takaki-maeda-99/PowerControlBoard/kicad/PowerControlBoard/PowerControlBoard.kicad_pcb

## KiCad design kicad/PowerControlBoard/PowerControlBoard.kicad_pcb (2025-08-18)

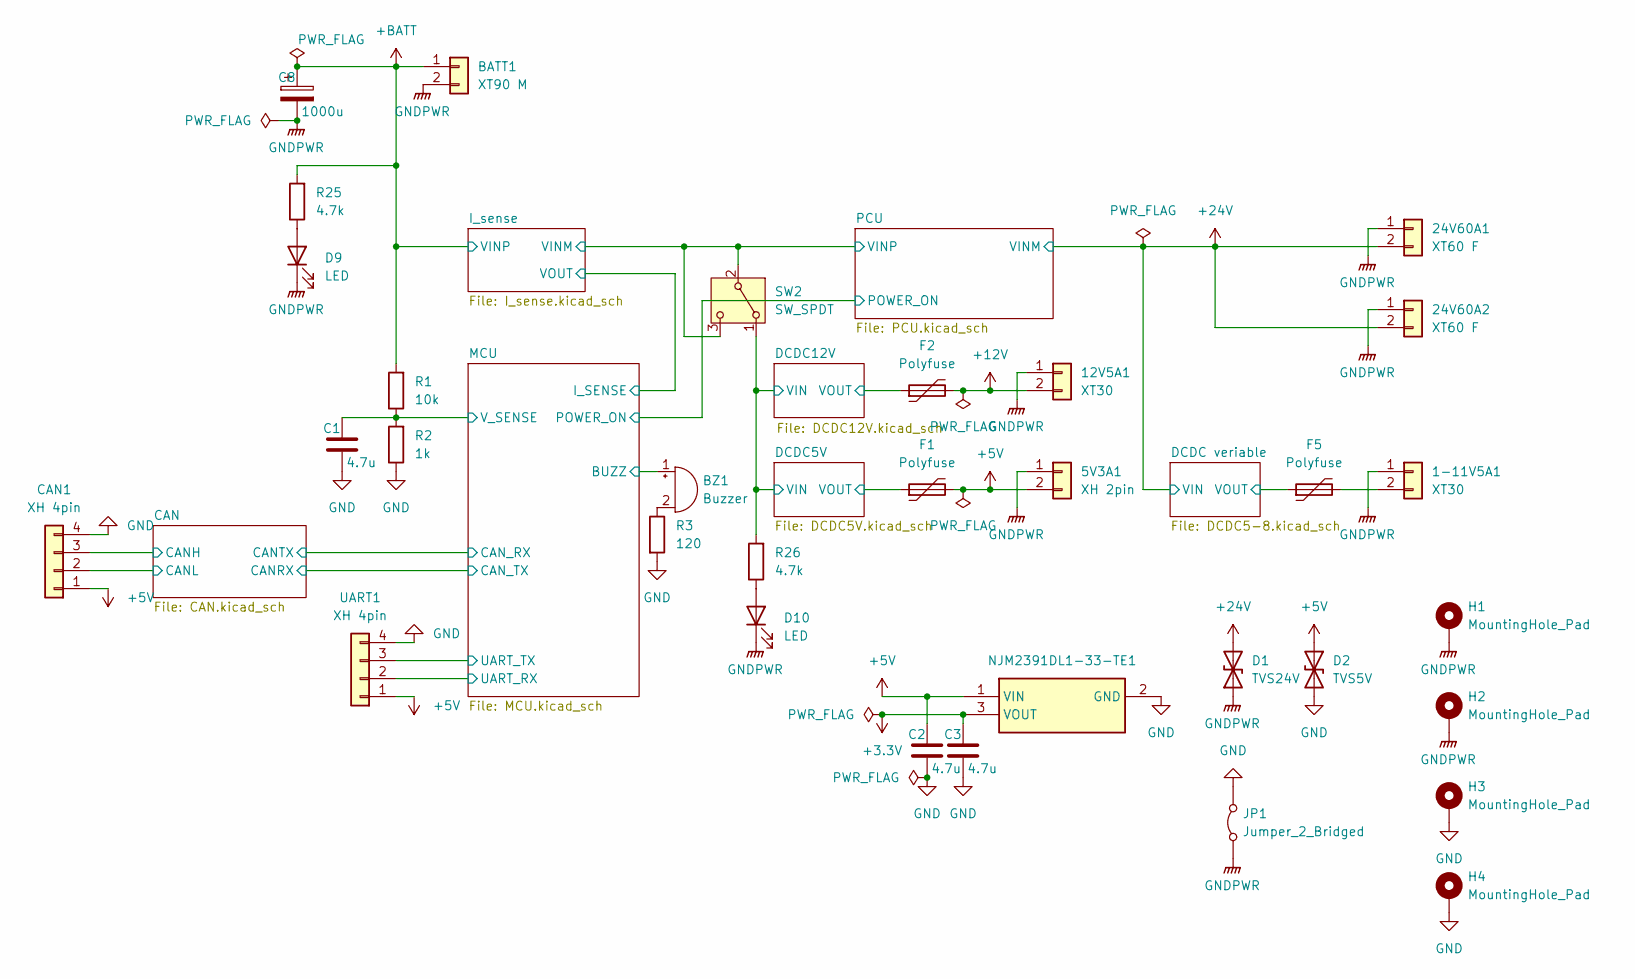
[picture p1: schematic PowerControlBoard.kicad_sch]

Parts:
1-11V5A1, 12V5A1: XT30; XT30UPBF
5V3A1: XH 2pin; JST_XH_S2B-XH-A_1x02_P2.50mm_Horizontal
24V60A1, 24V60A2: XT60 F; AMASS_XT60-F_1x02_P7.20mm_Vertical
BATT1: XT90 M; XT90PBF
BZ1: Buzzer; Buzzer_CUI_CPT-9019S-SMT
C1, C2, C3: 4.7u; C_0603_1608Metric
C8: 1000u; CP_Radial_D12.5mm_P5.00mm
CAN1: XH 4pin; JST_XH_S4B-XH-A_1x04_P2.50mm_Horizontal
D1: TVS24V; TO-277A
D2: TVS5V; D_SMB
D9, D10: LED; LED_0603_1608Metric
F1, F2, F5: Polyfuse; Fuse_Bourns_MF-RG500
H1, H2, H3, H4: MountingHole_Pad; MountingHole_3.2mm_M3_Pad
IC1: NJM2391DL1-33-TE1; NJM2391DL133TE1; Mouser Part Number 513-NJM2391DL133-TE1
JP1: Jumper_2_Bridged; SolderJumper-2_P1.3mm_Bridged2Bar_RoundedPad1.0x1.5mm
R1: 10k; R_0603_1608Metric
R2: 1k; R_0603_1608Metric
R3: 120; R_0603_1608Metric
R25, R26: 4.7k; C_0603_1608Metric
SW2: SW_SPDT; FanPinHeader_1x03_P2.54mm_Vertical
UART1: XH 4pin; JST_XH_S4B-XH-A_1x04_P2.50mm_Horizontal

Connections:
+3.3V: C3.1, IC1.3 (VOUT); also elsewhere on the board
+5V: 5V3A1.2, C2.1, CAN1.1, D2.1 (A1), F1.2, IC1.1 (VIN), UART1.1; also elsewhere on the board
+12V: 12V5A1.2, F2.2
+24V: 24V60A1.2, 24V60A2.2, D1.2 (A2); also elsewhere on the board
+BATT: BATT1.1, C8.1, R1.2, R25.2; also elsewhere on the board
/CAN/CANH: CAN1.3; also elsewhere on the board
/CAN/CANL: CAN1.2; also elsewhere on the board
/DCDC5V/VOUT: F1.1; also elsewhere on the board
/DCDC12V/VIN: R26.2, SW2.1 (A); also elsewhere on the board
/DCDC12V/VOUT: F2.1; also elsewhere on the board
/DCDC veriable/VOUT: F5.1; also elsewhere on the board
/I_sense/VINM: SW2.2 (B), SW2.3 (C); also elsewhere on the board
/MCU/BUZZ: BZ1.1 (+); also elsewhere on the board
/MCU/UART_RX: UART1.2; also elsewhere on the board
/MCU/UART_TX: UART1.3; also elsewhere on the board
/MCU/V_SENSE: C1.1, R1.1, R2.2; also elsewhere on the board
GND: C1.2, C2.2, C3.2, CAN1.4, D2.2 (A2), H3.1, H4.1, IC1.2 (GND), JP1.2 (B), R2.1, R3.2, UART1.4; also elsewhere on the board
GNDPWR: 1-11V5A1.1, 5V3A1.1, 12V5A1.1, 24V60A1.1, 24V60A2.1, BATT1.2, C8.2, D1.1 (A1), D9.1 (K), D10.1 (K), H1.1, H2.1, JP1.1 (A); also elsewhere on the board
unnamed: 1-11V5A1.2, F5.2
unnamed: BZ1.2 (-), R3.1
unnamed: D9.2 (A), R25.1
unnamed: D10.2 (A), R26.1

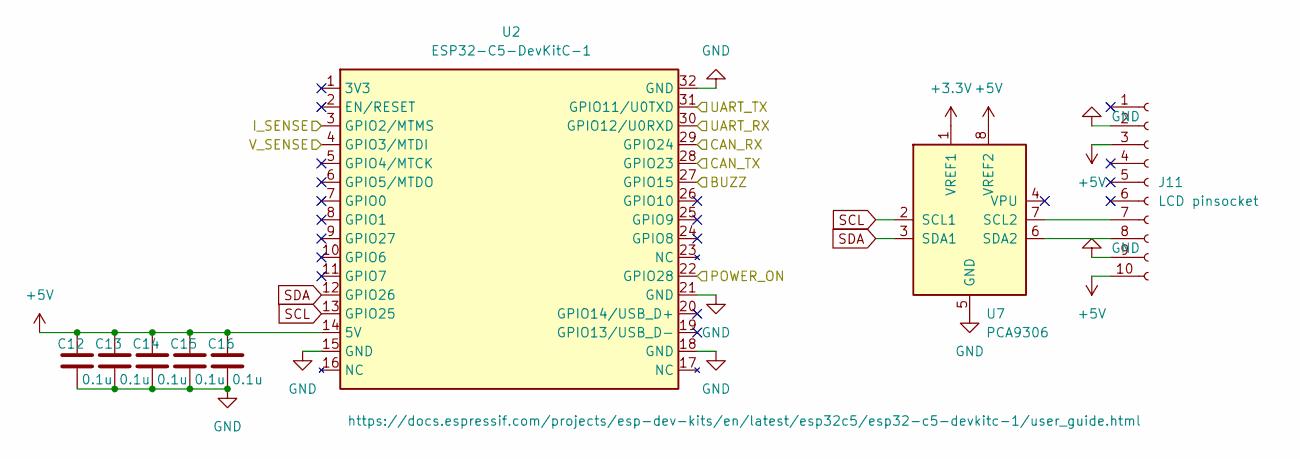
[picture p2: schematic MCU.kicad_sch]

Parts:
C12, C13, C14, C15, C16: 0.1u; C_0603_1608Metric
J11: LCD pinsocket; PinSocket_1x10_P2.54mm_Vertical
U2: ESP32-C5-DevKitC-1
U7: PCA9306; DIP-8_W10.16mm

Connections:
+3.3V: U7.1 (VREF1); also elsewhere on the board
+5V: C12.1, C13.1, C14.1, C15.1, C16.1, J11.3, J11.10, U2.14 (5V), U7.8 (VREF2); also elsewhere on the board
/CAN/CANRX: U2.28 (GPIO23); also elsewhere on the board
/CAN/CANTX: U2.29 (GPIO24); also elsewhere on the board
/I_sense/VOUT: U2.3 (GPIO2/MTMS); also elsewhere on the board
/MCU/BUZZ: U2.27 (GPIO15); also elsewhere on the board
/MCU/POWER_ON: U2.22 (GPIO28); also elsewhere on the board
/MCU/UART_RX: U2.30 (GPIO12/U0RXD); also elsewhere on the board
/MCU/UART_TX: U2.31 (GPIO11/U0TXD); also elsewhere on the board
/MCU/V_SENSE: U2.4 (GPIO3/MTDI); also elsewhere on the board
GND: C12.2, C13.2, C14.2, C15.2, C16.2, J11.2, J11.9, U2.15 (GND), U2.18 (GND), U2.21 (GND), U2.32 (GND), U7.5 (GND); also elsewhere on the board
unnamed: J11.7, U7.7 (SCL2)
unnamed: J11.8, U7.6 (SDA2)
SCL: U2.13 (GPIO25), U7.2 (SCL1)
SDA: U2.12 (GPIO26), U7.3 (SDA1)

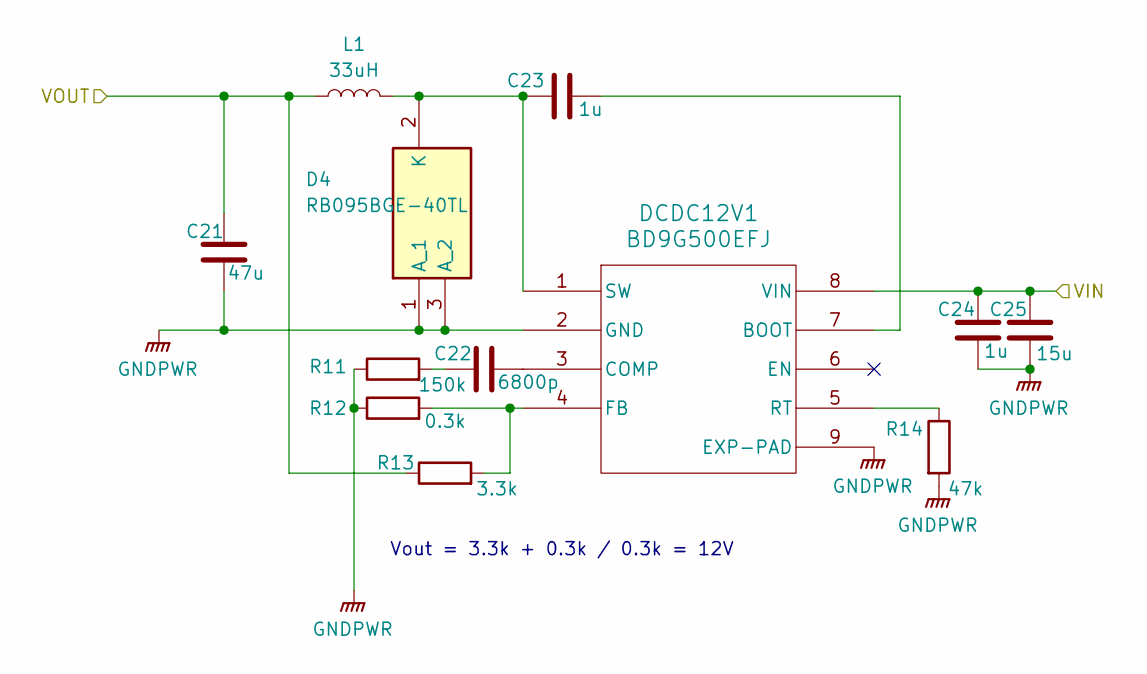
[picture p3: schematic DCDC12V.kicad_sch]

Parts:
C21: 47u; C_1206_3216Metric
C22: 6800p; C_0603_1608Metric
C23, C24: 1u; C_0603_1608Metric
C25: 15u; C_2220_5750Metric
D4: RB095BGE-40TL; RD3P175SNFRATL; Manufacturer_Part_Number RB095BGE-40TL; Mouser Part Number 755-RB095BGE-40TL
DCDC12V1: BD9G500EFJ; HTSOP-J8
L1: 33uH; IND_CSEB0660H-330M
R11: 150k; R_0603_1608Metric
R12: 0.3k; R_0603_1608Metric
R13: 3.3k; R_0603_1608Metric
R14: 47k; R_0603_1608Metric

Connections:
/DCDC12V/VIN: C24.1, C25.1, DCDC12V1.8 (VIN); also elsewhere on the board
/DCDC12V/VOUT: C21.2, L1.1, R13.1; also elsewhere on the board
GNDPWR: C21.1, C24.2, C25.2, D4.1 (A_1), D4.3 (A_2), DCDC12V1.2 (GND), DCDC12V1.9 (EXP-PAD), R11.1, R12.1, R14.2; also elsewhere on the board
unnamed: C22.1, R11.2
unnamed: C23.1, D4.2 (K), DCDC12V1.1 (SW), L1.2
unnamed: C23.2, DCDC12V1.7 (BOOT)
unnamed: C22.2, DCDC12V1.3 (COMP)
unnamed: DCDC12V1.4 (FB), R12.2, R13.2
unnamed: DCDC12V1.5 (RT), R14.1

Notes on the sheet:
Vout = 3.3k + 0.3k / 0.3k = 12V

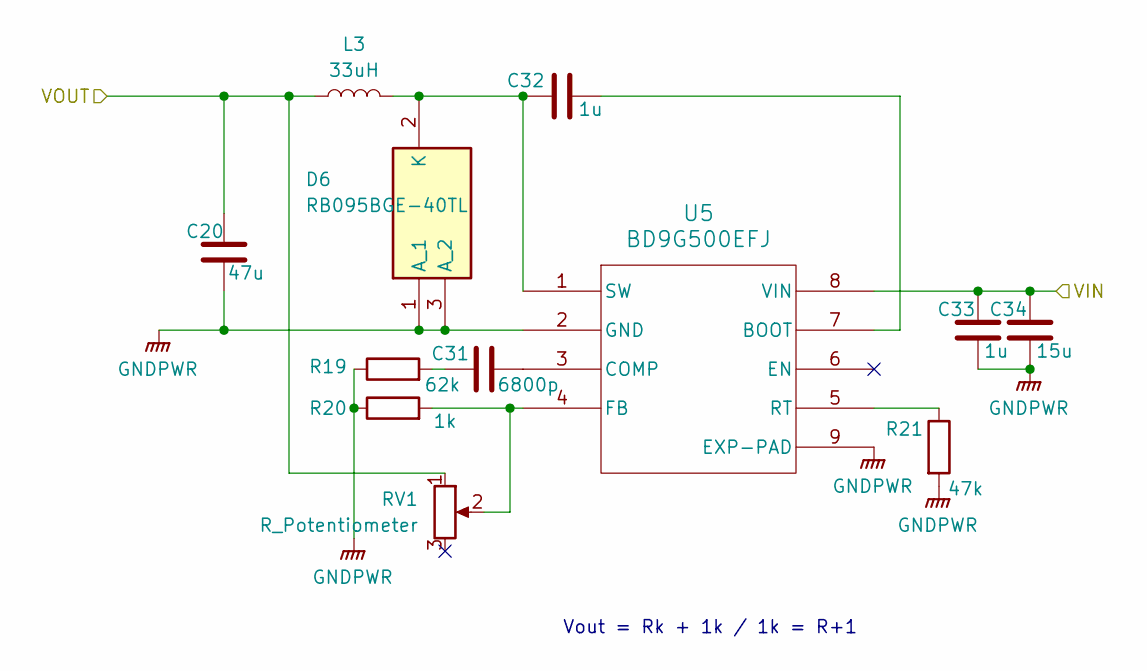
[picture p4: schematic DCDC5-8.kicad_sch]

Parts:
C20: 47u; C_1206_3216Metric
C31: 6800p; C_0603_1608Metric
C32, C33: 1u; C_0603_1608Metric
C34: 15u; C_2220_5750Metric
D6: RB095BGE-40TL; RD3P175SNFRATL; Manufacturer_Part_Number RB095BGE-40TL; Mouser Part Number 755-RB095BGE-40TL
L3: 33uH; IND_CSEB0660H-330M
R19: 62k; R_0603_1608Metric
R20: 1k; R_0603_1608Metric
R21: 47k; R_0603_1608Metric
RV1: R_Potentiometer; Potentiometer_Bourns_3386P_Vertical
U5: BD9G500EFJ; HTSOP-J8

Connections:
+24V: C33.1, C34.1, U5.8 (VIN); also elsewhere on the board
/DCDC veriable/VOUT: C20.2, L3.1, RV1.1; also elsewhere on the board
GNDPWR: C20.1, C33.2, C34.2, D6.1 (A_1), D6.3 (A_2), R19.1, R20.1, R21.2, U5.2 (GND), U5.9 (EXP-PAD); also elsewhere on the board
unnamed: C31.1, R19.2
unnamed: C32.1, D6.2 (K), L3.2, U5.1 (SW)
unnamed: C32.2, U5.7 (BOOT)
unnamed: C31.2, U5.3 (COMP)
unnamed: R20.2, RV1.2, U5.4 (FB)
unnamed: R21.1, U5.5 (RT)

Notes on the sheet:
Vout = Rk + 1k / 1k = R+1

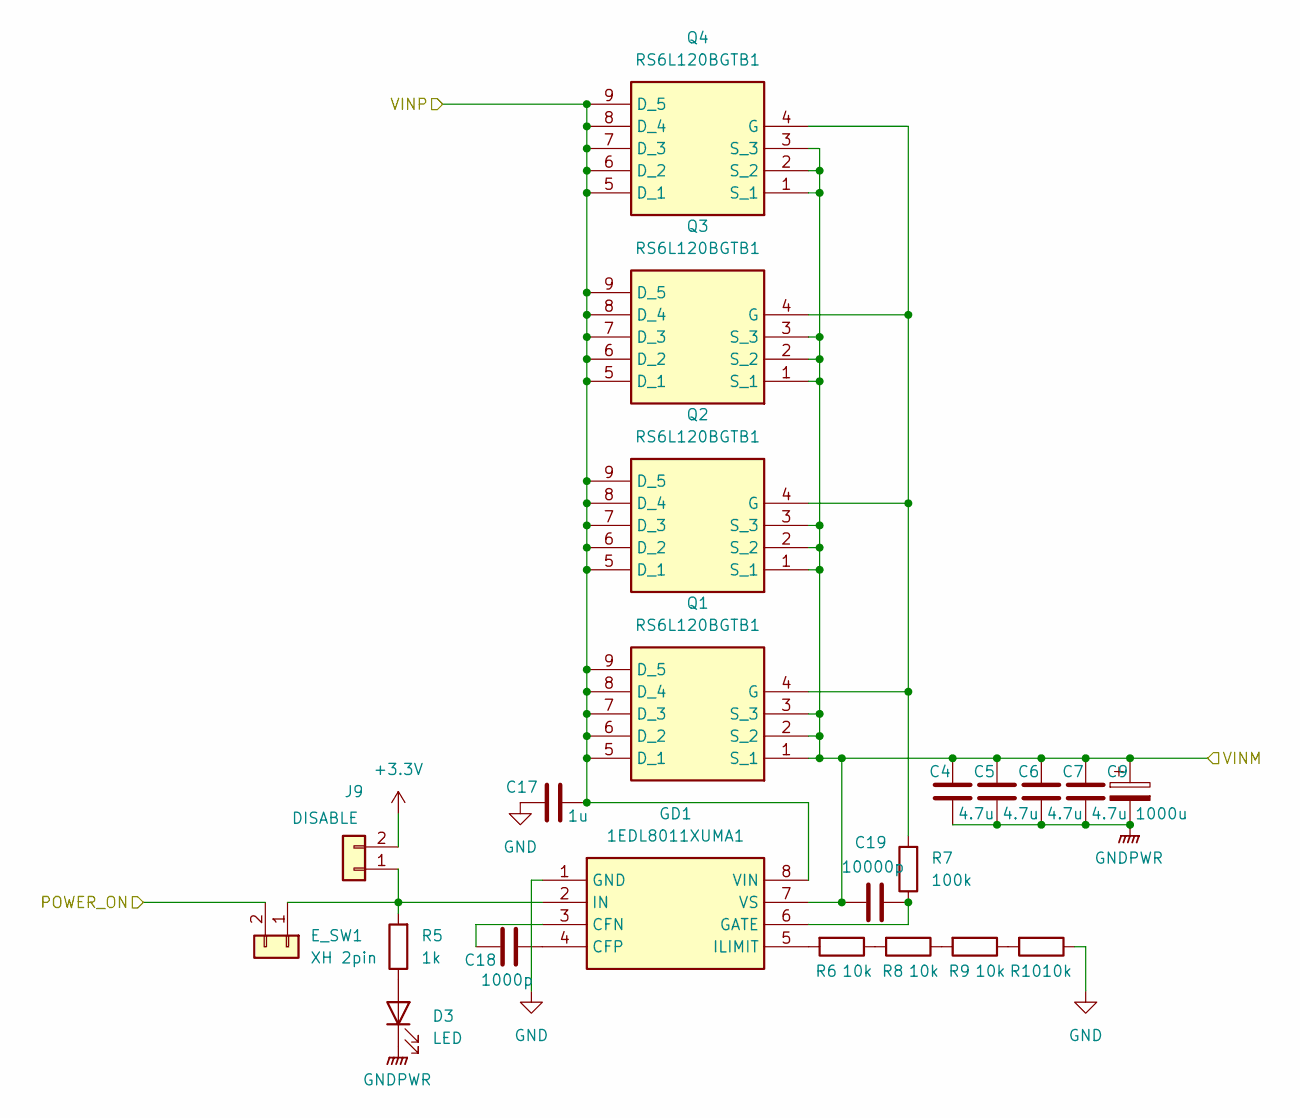
[picture p5: schematic PCU.kicad_sch]

Parts:
C4, C5, C6, C7: 4.7u; C_0603_1608Metric
C9: 1000u; CP_Radial_D12.5mm_P5.00mm
C17: 1u; C_0603_1608Metric
C18: 1000p; C_0603_1608Metric
C19: 10000p; C_0603_1608Metric
D3: LED; LED_0603_1608Metric
E_SW1: XH 2pin; JST_XH_B2B-XH-A_1x02_P2.50mm_Vertical
GD1: 1EDL8011XUMA1; SOIC127P600X175-8N; Mouser Part Number 726-1EDL8011XUMA1
J9: DISABLE; PinHeader_1x02_P2.54mm_Vertical
Q1, Q2, Q3, Q4: RS6L120BGTB1; RS1L151ATTB1; Manufacturer_Part_Number RS6L120BGTB1; Mouser Part Number 755-RS6L120BGTB1
R5: 1k; R_0603_1608Metric
R6, R8, R9, R10: 10k; R_0603_1608Metric
R7: 100k; R_0603_1608Metric

Connections:
+3.3V: J9.2; also elsewhere on the board
+24V: C4.1, C5.1, C6.1, C7.1, C9.1, C19.1, GD1.7 (VS), Q1.1 (S_1), Q1.2 (S_2), Q1.3 (S_3), Q2.1 (S_1), Q2.2 (S_2), Q2.3 (S_3), Q3.1 (S_1), Q3.2 (S_2), Q3.3 (S_3), Q4.1 (S_1), Q4.2 (S_2), Q4.3 (S_3); also elsewhere on the board
/I_sense/VINM: C17.1, GD1.8 (VIN), Q1.5 (D_1), Q1.6 (D_2), Q1.7 (D_3), Q1.8 (D_4), Q1.9 (D_5), Q2.5 (D_1), Q2.6 (D_2), Q2.7 (D_3), Q2.8 (D_4), Q2.9 (D_5), Q3.5 (D_1), Q3.6 (D_2), Q3.7 (D_3), Q3.8 (D_4), Q3.9 (D_5), Q4.5 (D_1), Q4.6 (D_2), Q4.7 (D_3), Q4.8 (D_4), Q4.9 (D_5); also elsewhere on the board
/MCU/POWER_ON: E_SW1.2; also elsewhere on the board
GND: C17.2, GD1.1 (GND), R10.1; also elsewhere on the board
GNDPWR: C4.2, C5.2, C6.2, C7.2, C9.2, D3.1 (K); also elsewhere on the board
unnamed: D3.2 (A), R5.1
unnamed: E_SW1.1, GD1.2 (IN), J9.1, R5.2
unnamed: C18.1, GD1.3 (CFN)
unnamed: C18.2, GD1.4 (CFP)
unnamed: C19.2, GD1.6 (GATE), R7.1
unnamed: GD1.5 (ILIMIT), R6.2
unnamed: Q1.4 (G), Q2.4 (G), Q3.4 (G), Q4.4 (G), R7.2
unnamed: R6.1, R8.2
unnamed: R8.1, R9.2
unnamed: R9.1, R10.2

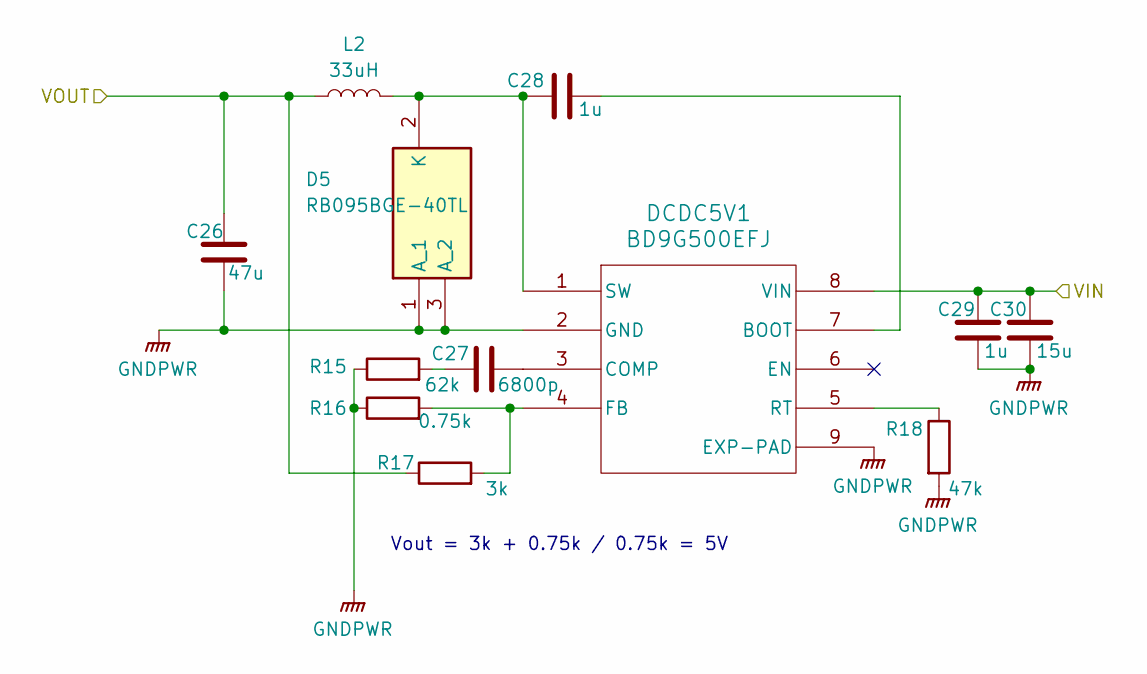
[picture p6: schematic DCDC5V.kicad_sch]

Parts:
C26: 47u; C_1206_3216Metric
C27: 6800p; C_0603_1608Metric
C28, C29: 1u; C_0603_1608Metric
C30: 15u; C_2220_5750Metric
D5: RB095BGE-40TL; RD3P175SNFRATL; Manufacturer_Part_Number RB095BGE-40TL; Mouser Part Number 755-RB095BGE-40TL
DCDC5V1: BD9G500EFJ; HTSOP-J8
L2: 33uH; IND_CSEB0660H-330M
R15: 62k; R_0603_1608Metric
R16: 0.75k; R_0603_1608Metric
R17: 3k; R_0603_1608Metric
R18: 47k; R_0603_1608Metric

Connections:
/DCDC5V/VOUT: C26.2, L2.1, R17.1; also elsewhere on the board
/DCDC12V/VIN: C29.1, C30.1, DCDC5V1.8 (VIN); also elsewhere on the board
GNDPWR: C26.1, C29.2, C30.2, D5.1 (A_1), D5.3 (A_2), DCDC5V1.2 (GND), DCDC5V1.9 (EXP-PAD), R15.1, R16.1, R18.2; also elsewhere on the board
unnamed: C27.1, R15.2
unnamed: C28.1, D5.2 (K), DCDC5V1.1 (SW), L2.2
unnamed: C28.2, DCDC5V1.7 (BOOT)
unnamed: C27.2, DCDC5V1.3 (COMP)
unnamed: DCDC5V1.4 (FB), R16.2, R17.2
unnamed: DCDC5V1.5 (RT), R18.1

Notes on the sheet:
Vout = 3k + 0.75k / 0.75k = 5V

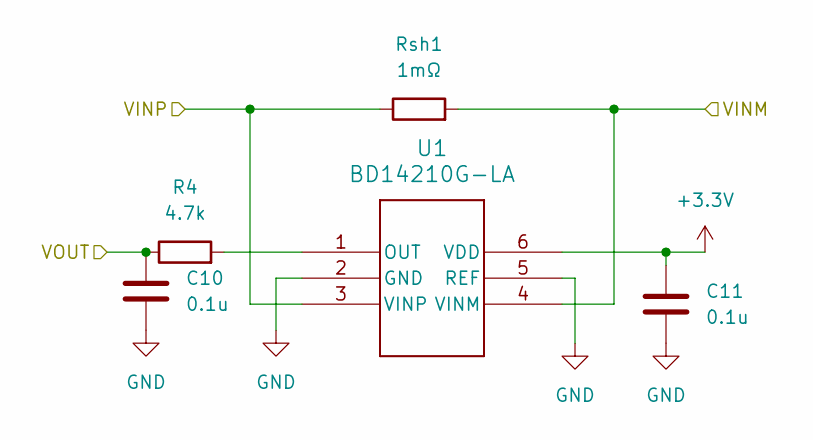
[picture p7: schematic I_sense.kicad_sch]

Parts:
C10, C11: 0.1u; C_0603_1608Metric
R4: 4.7k; R_0603_1608Metric
Rsh1: 1mΩ; R_2512_6332Metric
U1: BD14210G-LA; SSOP6

Connections:
+3.3V: C11.1, U1.6 (VDD); also elsewhere on the board
+BATT: Rsh1.1, U1.3 (VINP); also elsewhere on the board
/I_sense/VINM: Rsh1.2, U1.4 (VINM); also elsewhere on the board
/I_sense/VOUT: C10.1, R4.1; also elsewhere on the board
GND: C10.2, C11.2, U1.2 (GND), U1.5 (REF); also elsewhere on the board
unnamed: R4.2, U1.1 (OUT)

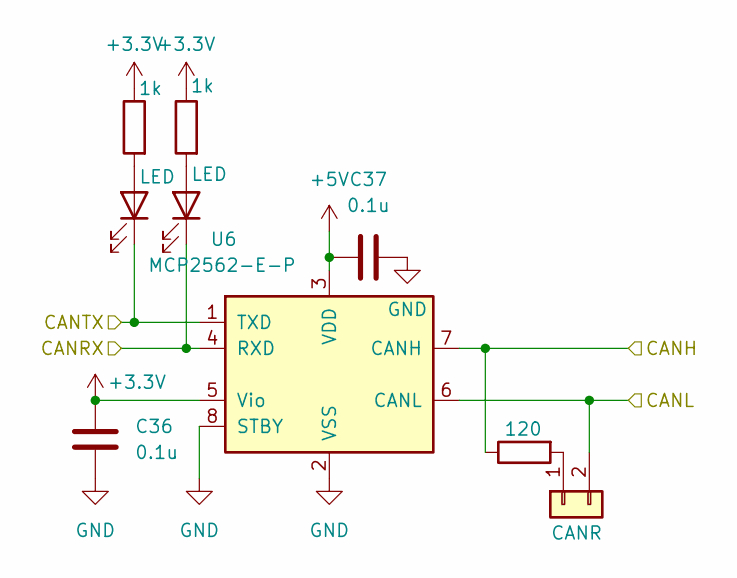
[picture p8: schematic CAN.kicad_sch]

Parts:
C36, C37: 0.1u; C_0603_1608Metric
D7, D8: LED; LED_0603_1608Metric
J10: CANR; PinHeader_1x02_P2.54mm_Vertical
R22, R23: 1k; R_0603_1608Metric
R24: 120; R_0603_1608Metric
U6: MCP2562-E-P; DIP-8_W7.62mm

Connections:
+3.3V: C36.2, R22.1, R23.1, U6.5 (Vio); also elsewhere on the board
+5V: C37.2, U6.3 (VDD); also elsewhere on the board
/CAN/CANH: R24.1, U6.7 (CANH); also elsewhere on the board
/CAN/CANL: J10.2, U6.6 (CANL); also elsewhere on the board
/CAN/CANRX: D8.1 (K), U6.4 (RXD); also elsewhere on the board
/CAN/CANTX: D7.1 (K), U6.1 (TXD); also elsewhere on the board
GND: C36.1, C37.1, U6.2 (VSS), U6.8 (STBY); also elsewhere on the board
unnamed: D7.2 (A), R22.2
unnamed: D8.2 (A), R23.2
unnamed: J10.1, R24.2

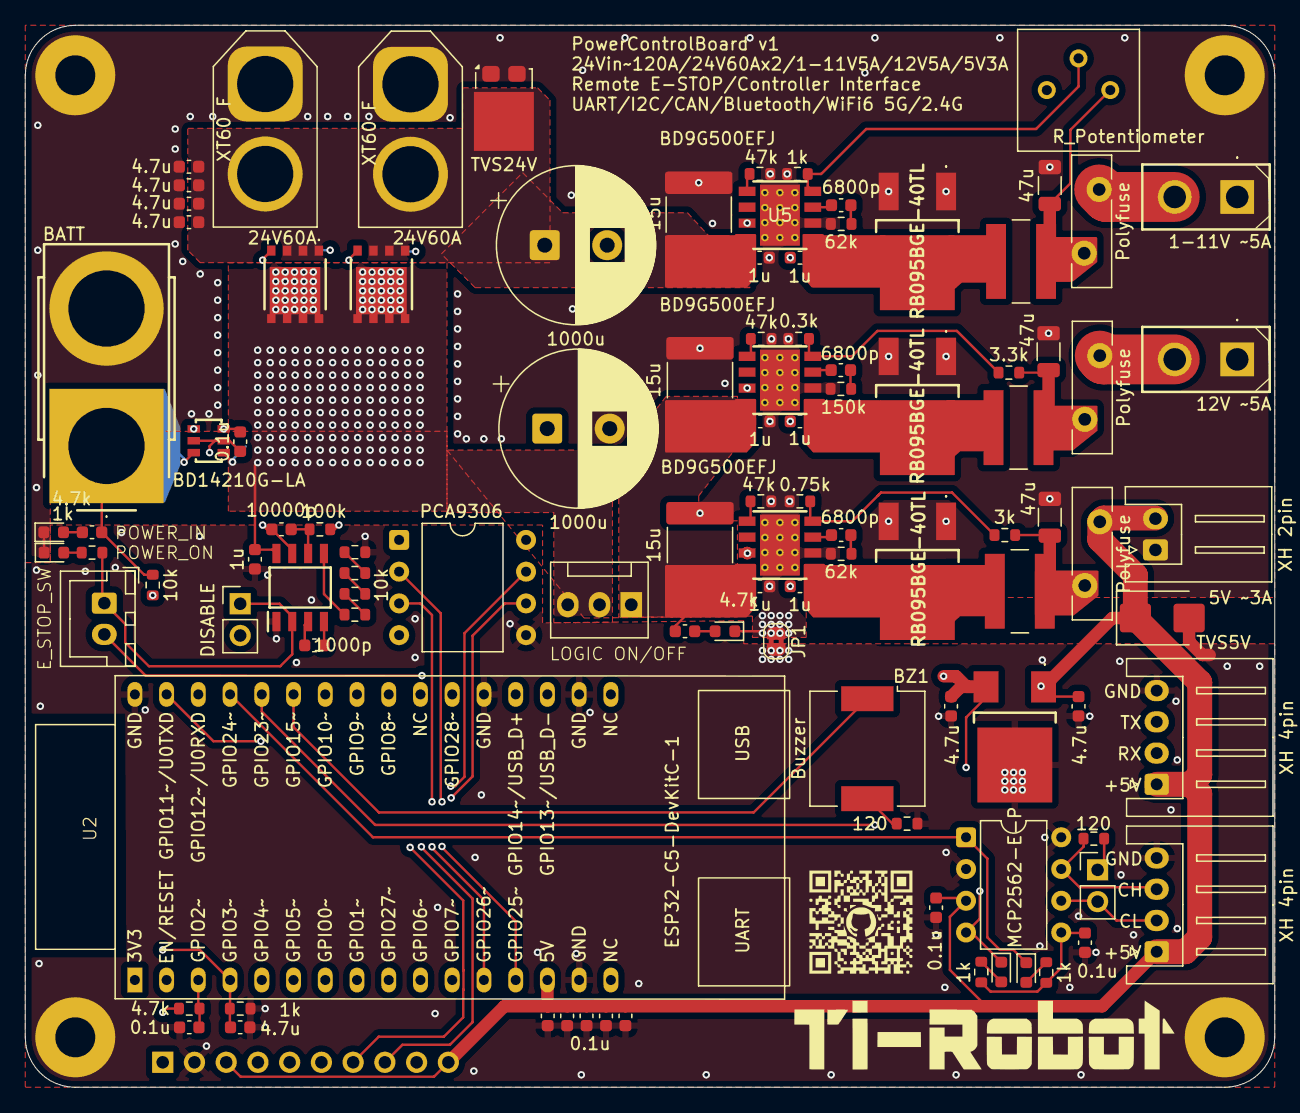
[picture p9: board PowerControlBoard.kicad_pcb from above]

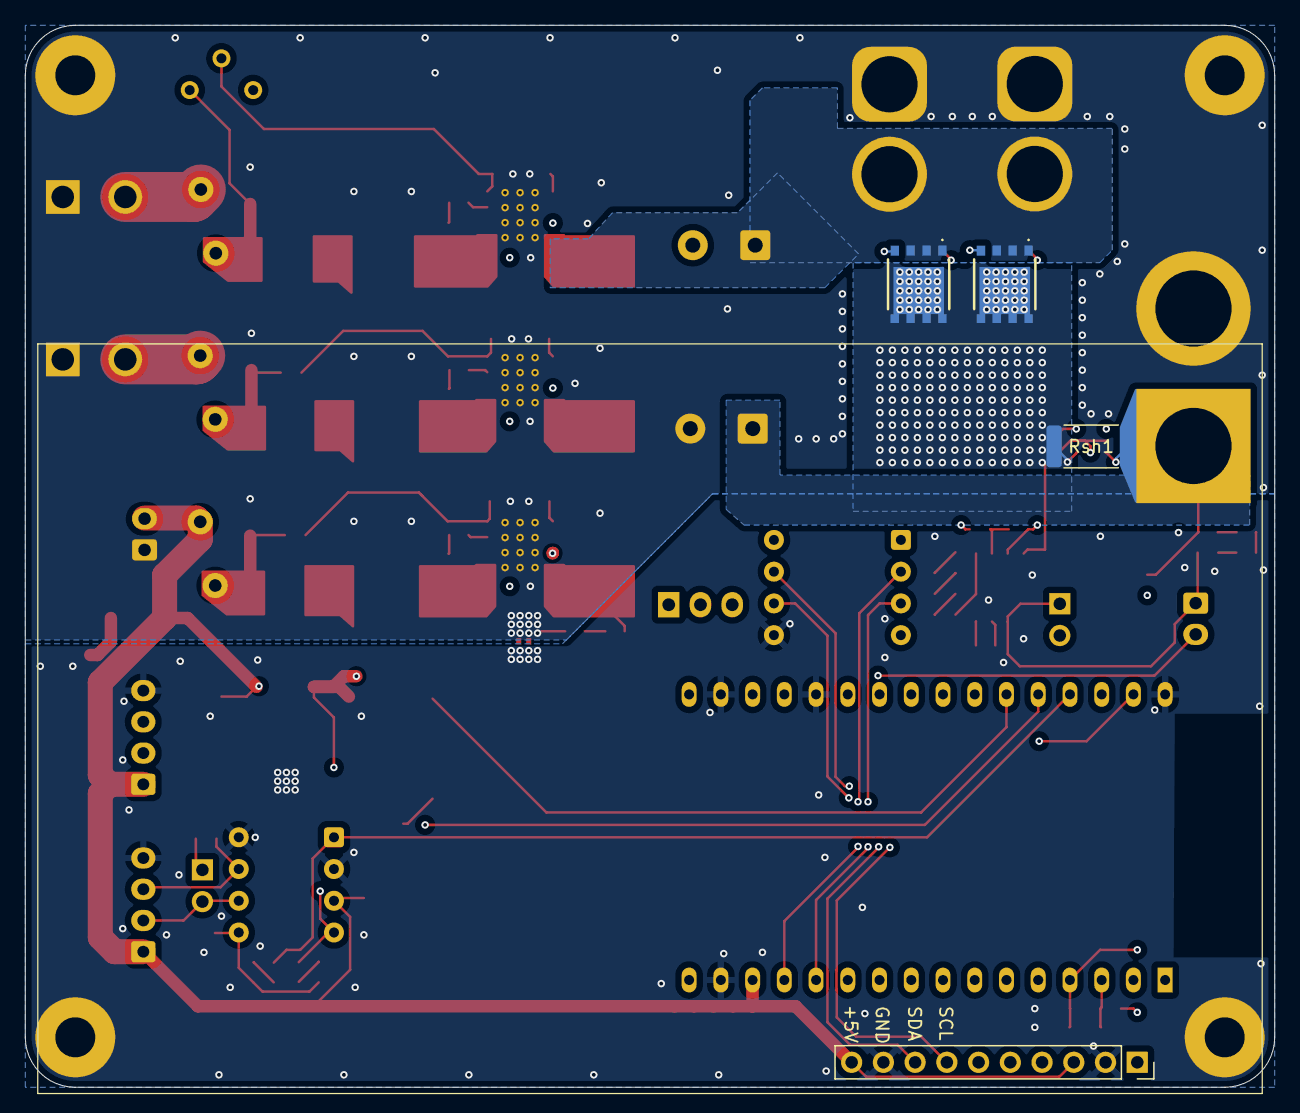
[picture p10: board PowerControlBoard.kicad_pcb from below]

Board: 4 copper layers, 100.0 x 85.0 mm, 112 parts (4 on the bottom side), 62 nets.
